OpenSourceEBike/ebike_wireless_remote/README.md

# DEPRECATED.
Use this one instead: https://github.com/OpenSourceEBike/TSDZ2_wireless
