OpenSourceEBike/ebike_wireless_remote/documentation/ant_lev+bluetooth_connected.png

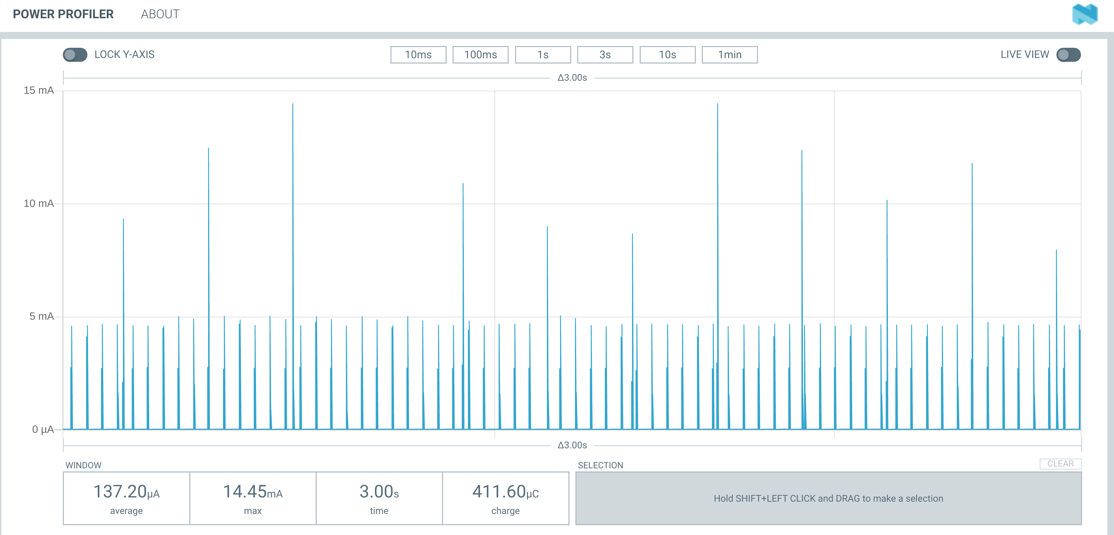
documentation/ant_lev+bluetooth_connected.png
