OpenSourceEBike/ebike_wireless_remote/documentation/ant_lev+bluetooth_idle.png

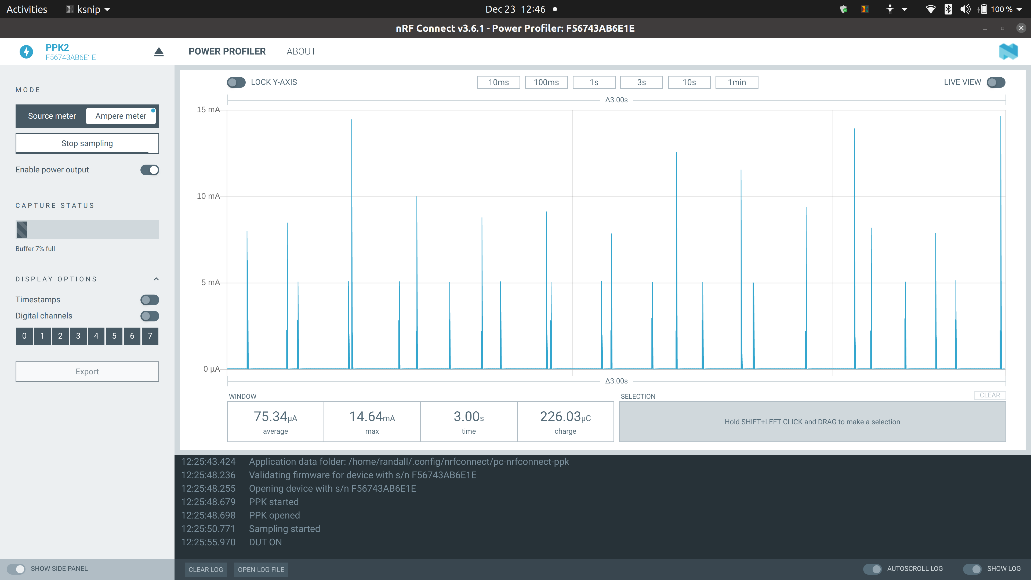
documentation/ant_lev+bluetooth_idle.png
