OpenSourceEBike/ebike_wireless_remote/documentation/ant_lev+bluetooth_pairing.png

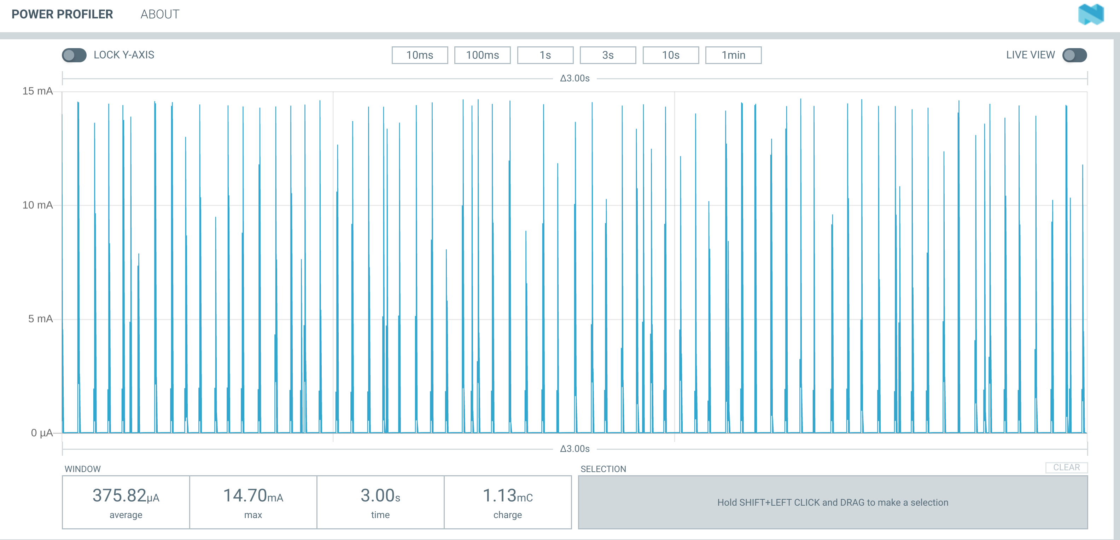
documentation/ant_lev+bluetooth_pairing.png
