OpenSourceEBike/ebike_wireless_remote/documentation/ant_lev+ctrl_2_sec_press.png

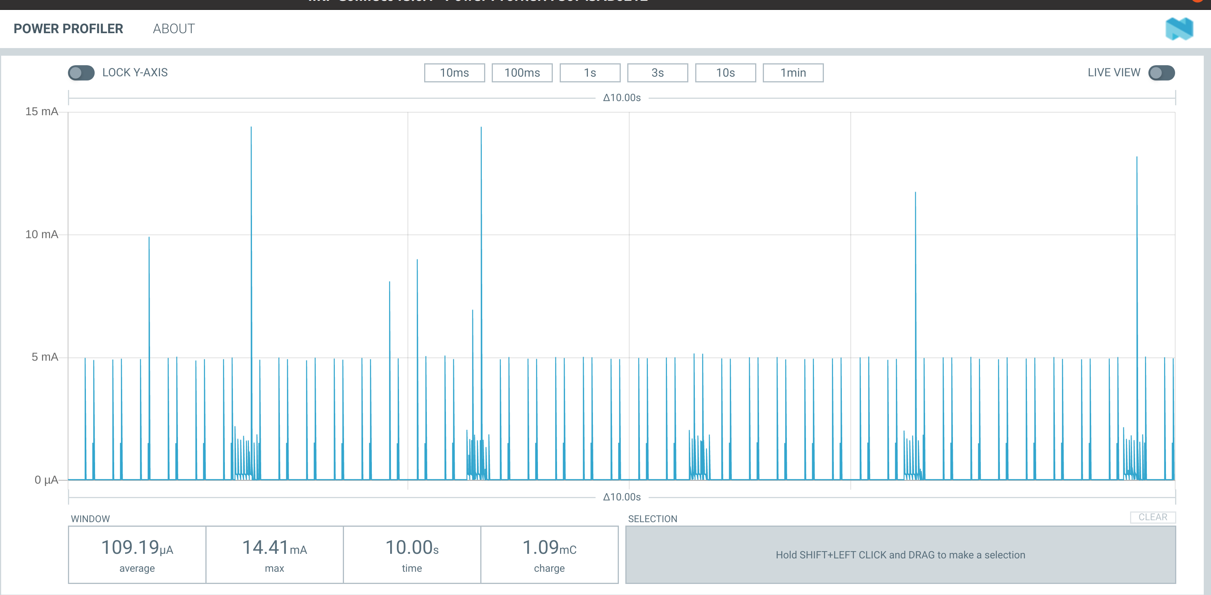
documentation/ant_lev+ctrl_2_sec_press.png
