OpenSourceEBike/ebike_wireless_remote/documentation/ant_lev+ctrl_idle.png

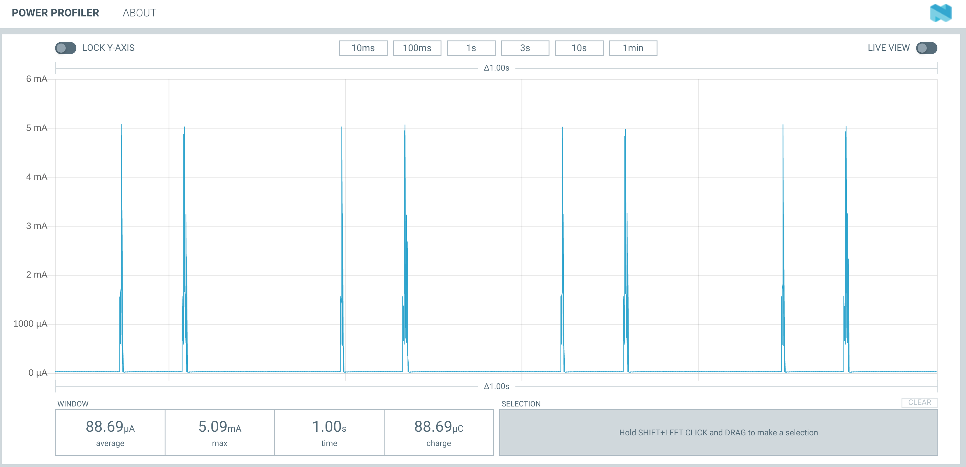
documentation/ant_lev+ctrl_idle.png
