OpenSourceEBike/ebike_wireless_remote/documentation/ant_lev_1_sec_press.png

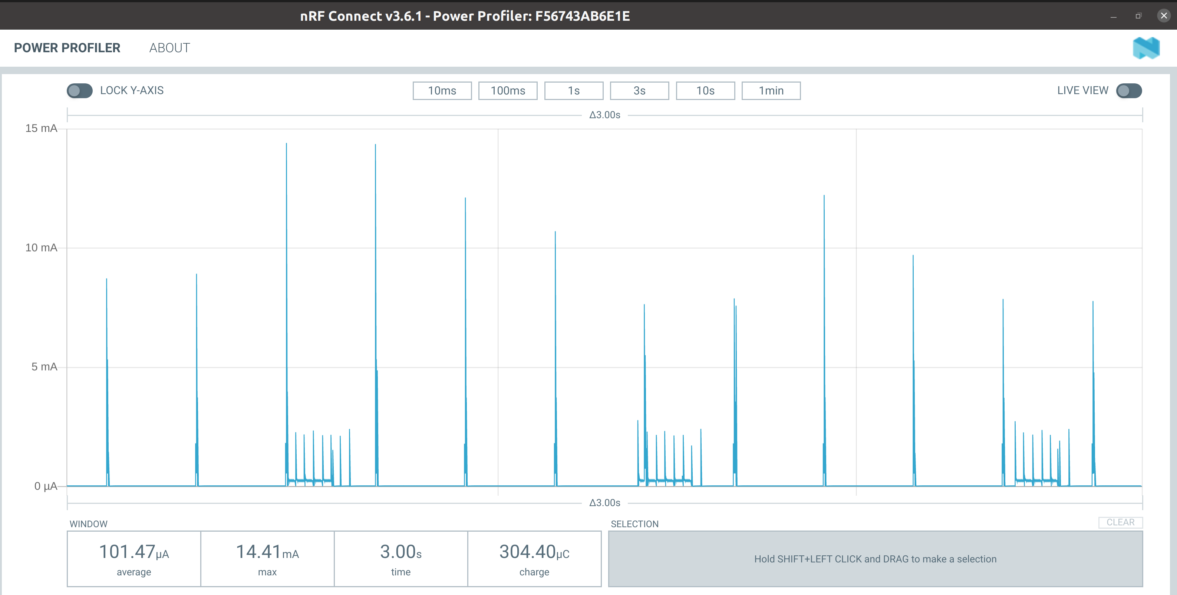
documentation/ant_lev_1_sec_press.png
