OpenSourceEBike/ebike_wireless_remote/documentation/ant_lev_2_sec_press.png

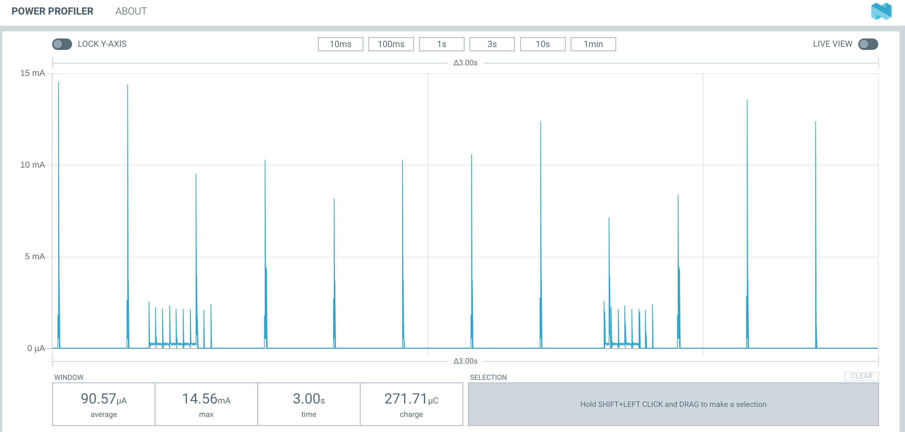
documentation/ant_lev_2_sec_press.png
