OpenSourceEBike/ebike_wireless_remote/documentation/ant_lev_idle.png

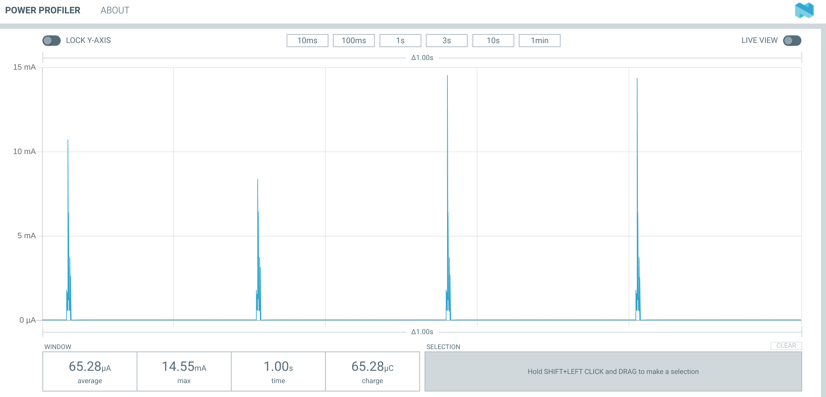
documentation/ant_lev_idle.png
