OpenSourceEBike/ebike_wireless_remote/documentation/ant_pairing.png

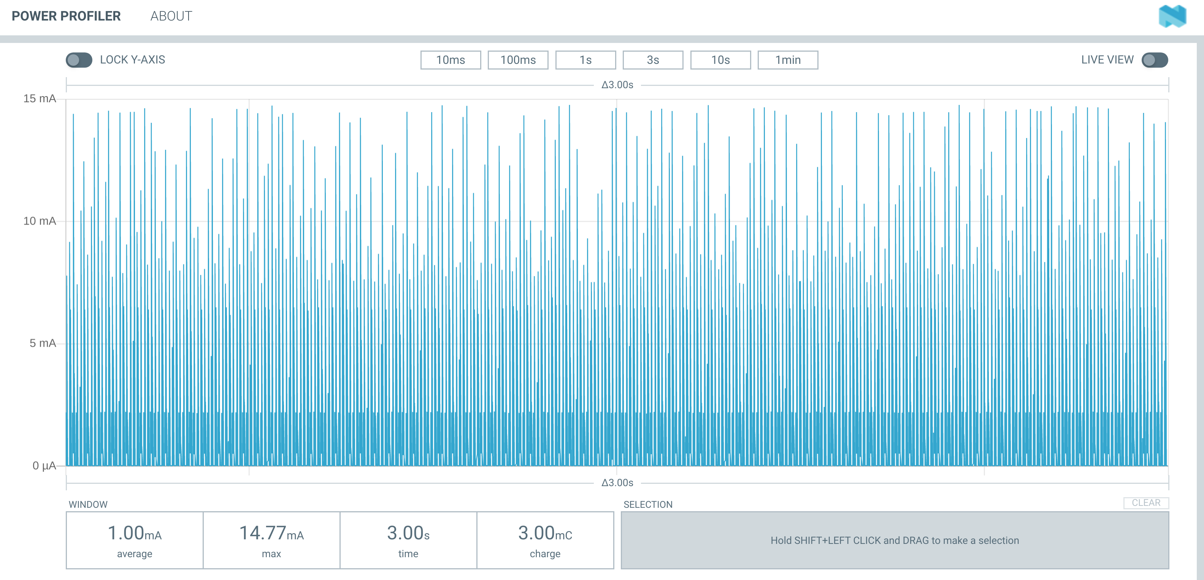
documentation/ant_pairing.png
