OpenSourceEBike/ebike_wireless_remote/documentation/battery_life.png

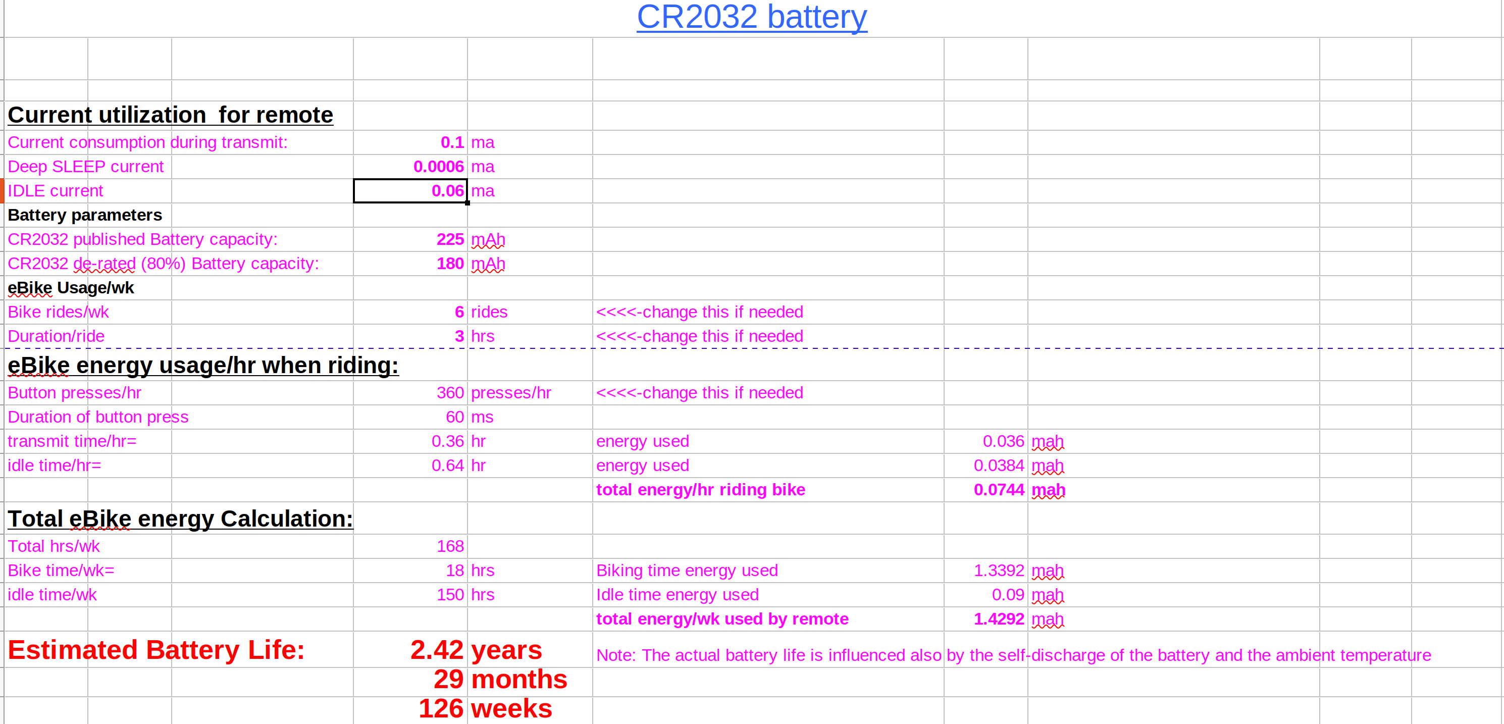
documentation/battery_life.png
