OpenSourceEBike/ebike_wireless_remote/documentation/capacity_vs_pulse_amplitude.png

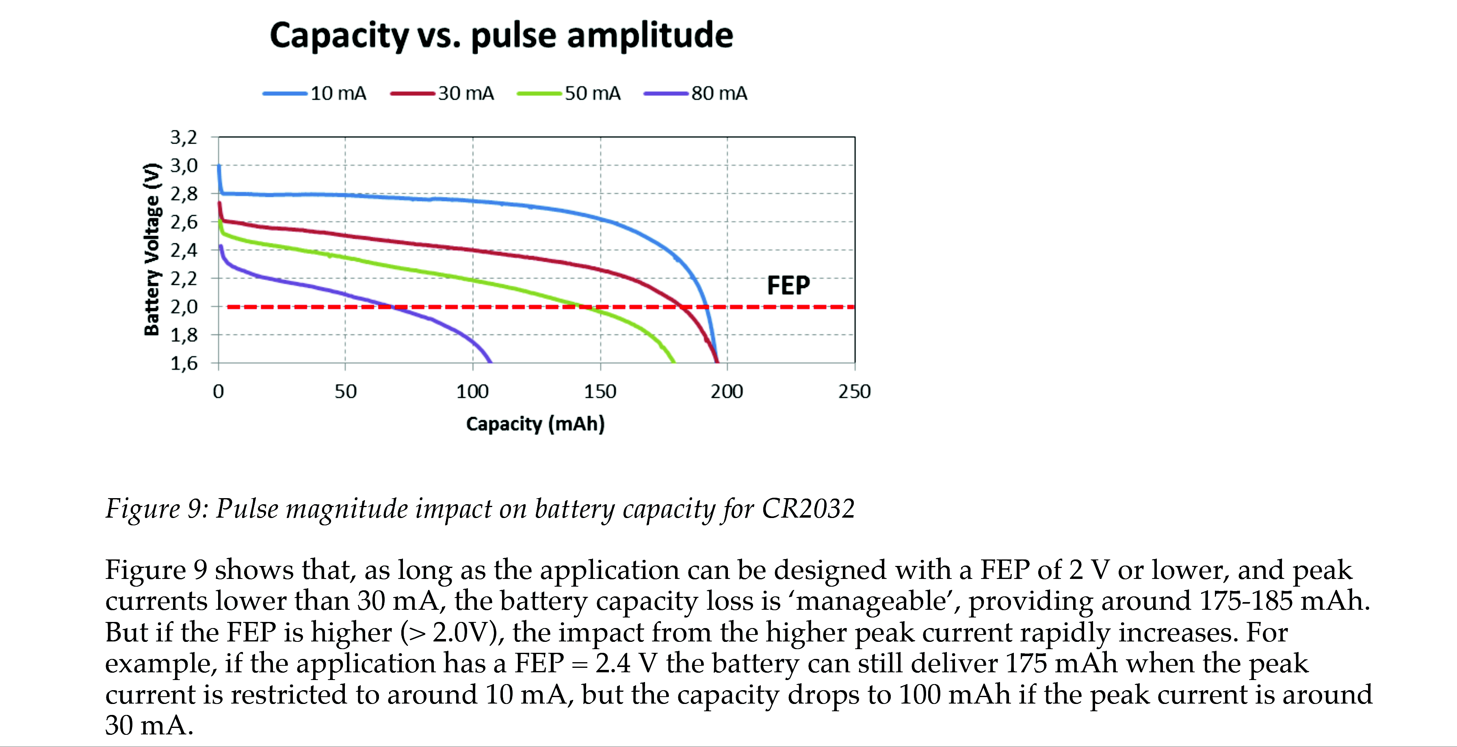
documentation/capacity_vs_pulse_amplitude.png
