OpenSourceEBike/ebike_wireless_remote/documentation/deep_sleep.png

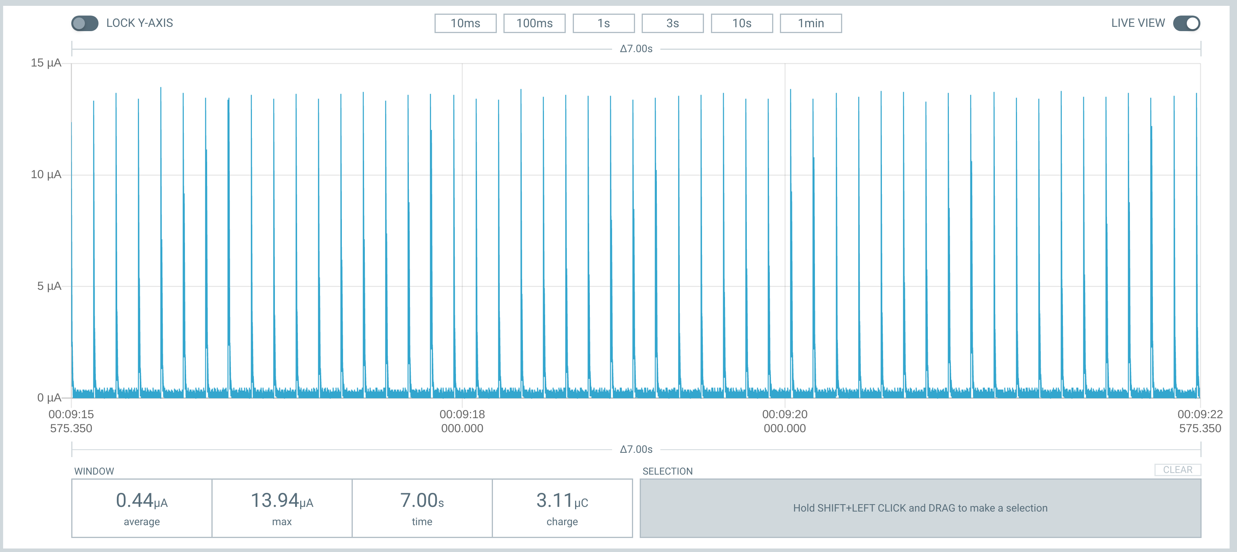
documentation/deep_sleep.png
