OpenSourceEBike/ebike_wireless_remote/documentation/duration_of_button_click.png

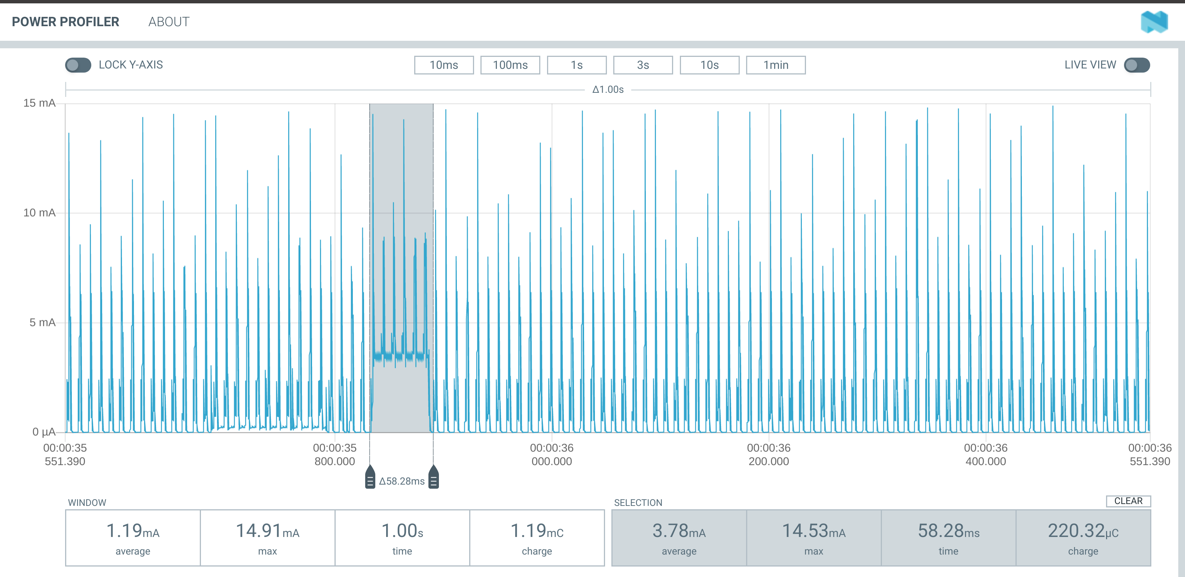
documentation/duration_of_button_click.png
