OpenSourceEBike/ebike_wireless_remote/documentation/external_power.png

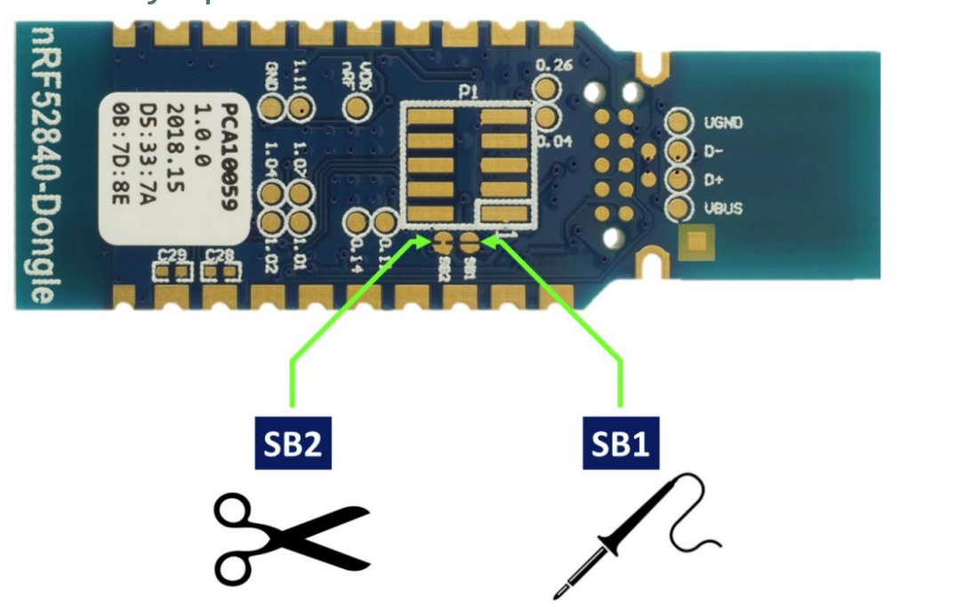
documentation/external_power.png
