OpenSourceEBike/ebike_wireless_remote/documentation/external_source.png

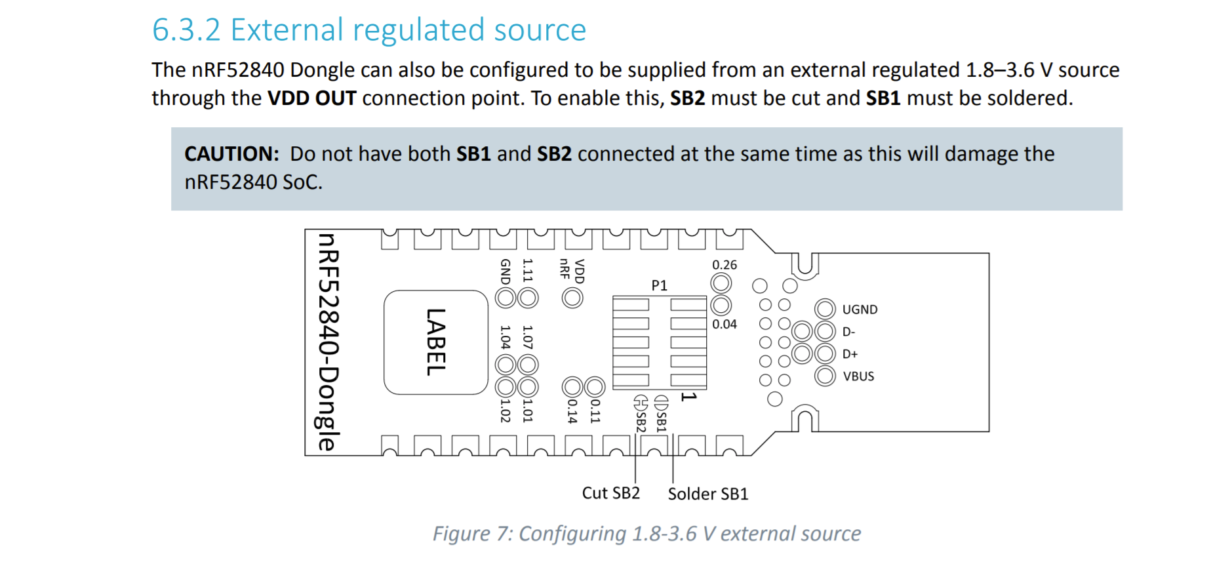
documentation/external_source.png
