OpenSourceEBike/ebike_wireless_remote/documentation/led_current.png

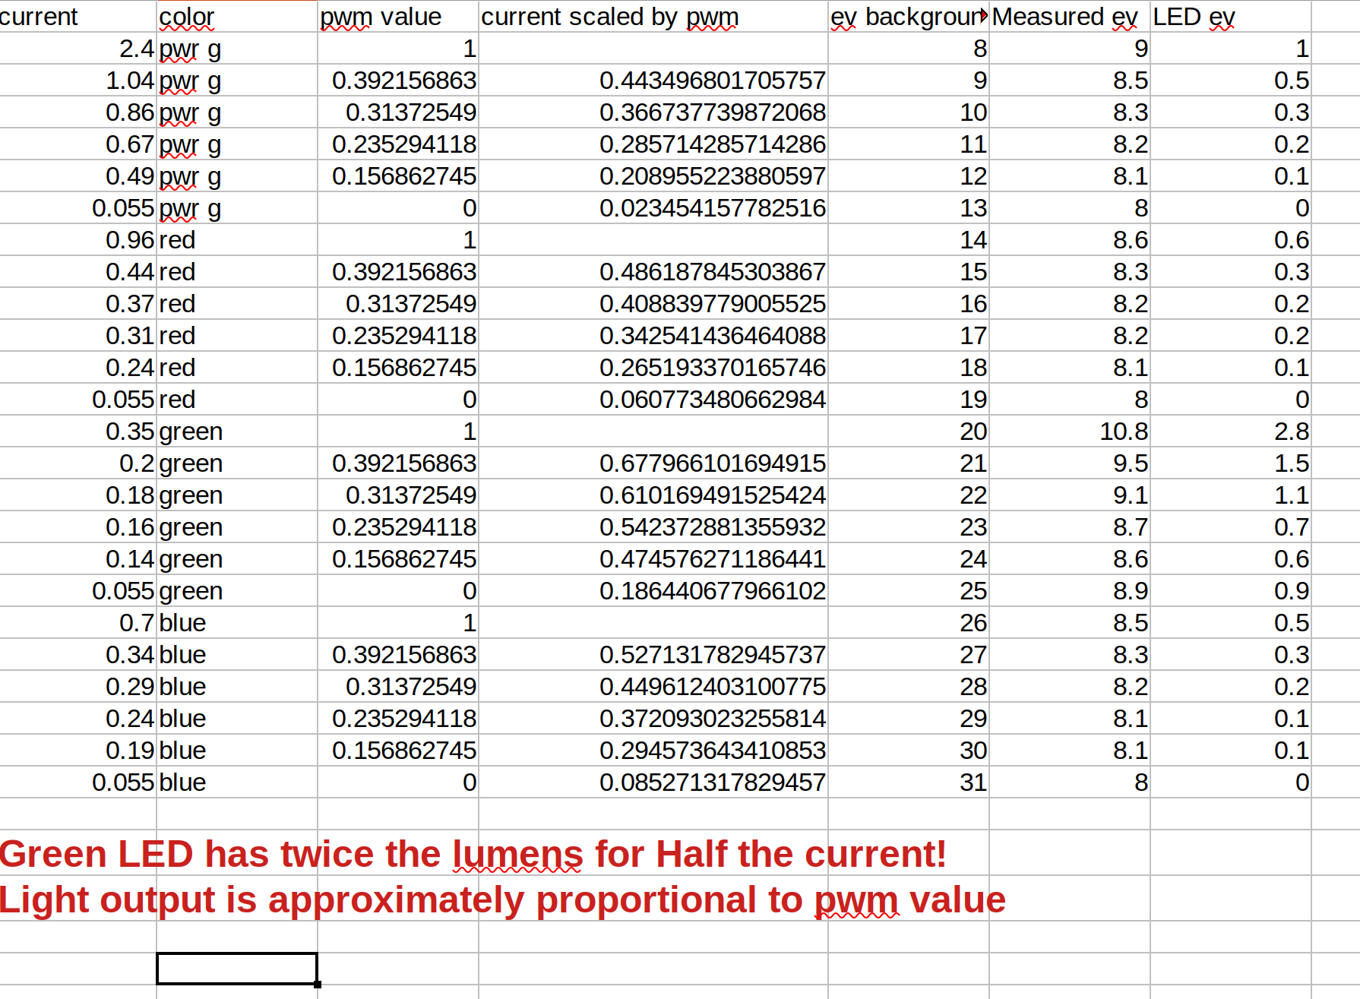
documentation/led_current.png
