OpenSourceEBike/ebike_wireless_remote/documentation/leds_active.png

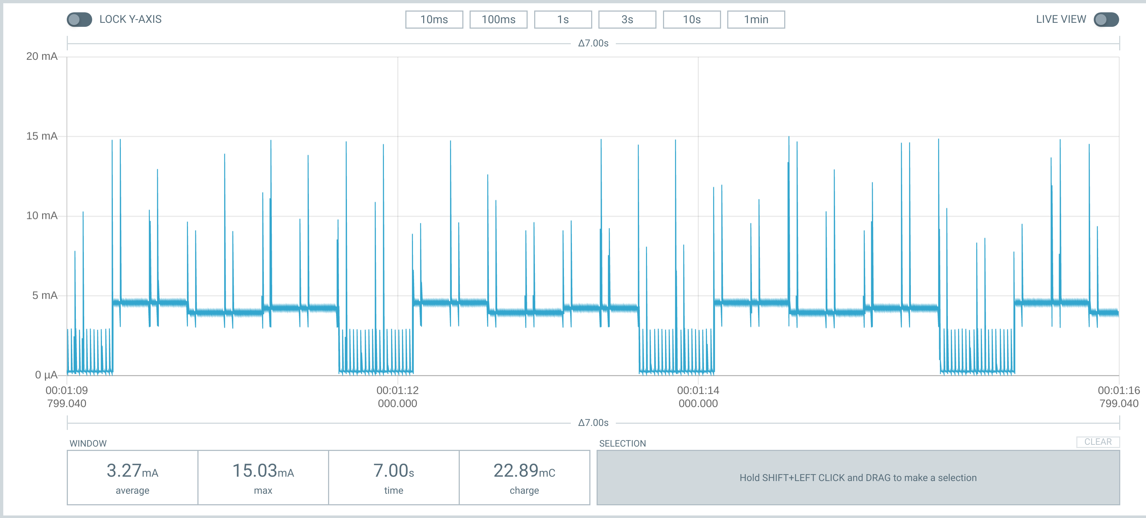
documentation/leds_active.png
