OpenSourceEBike/ebike_wireless_remote/documentation/no ant device found.png

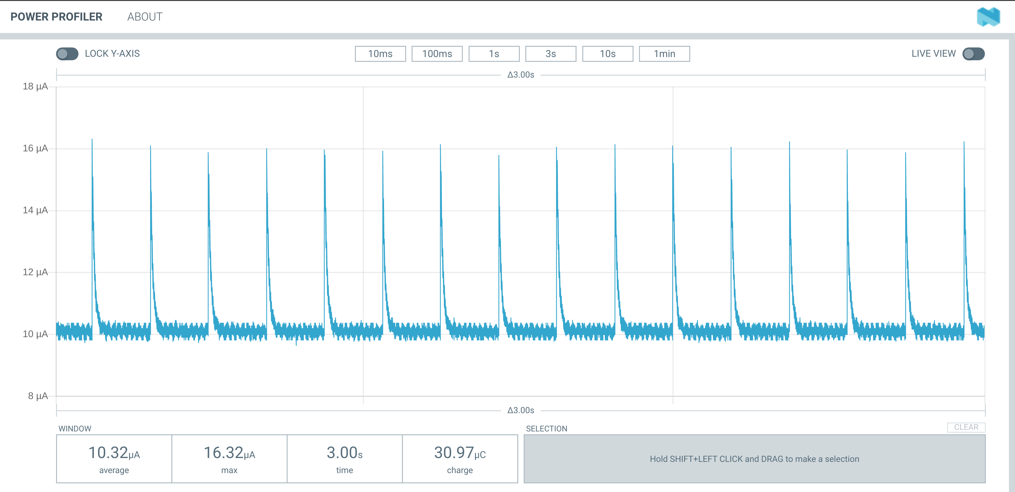
documentation/no ant device found.png
