OpenSourceEBike/ebike_wireless_remote/documentation/nRF52840 Dongle Pinout.png

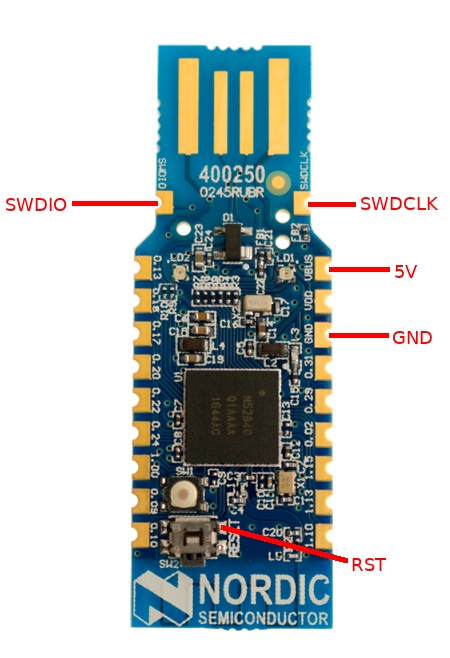
documentation/nRF52840 Dongle Pinout.png
