OpenSourceEBike/ebike_wireless_remote/documentation/openocd1.png

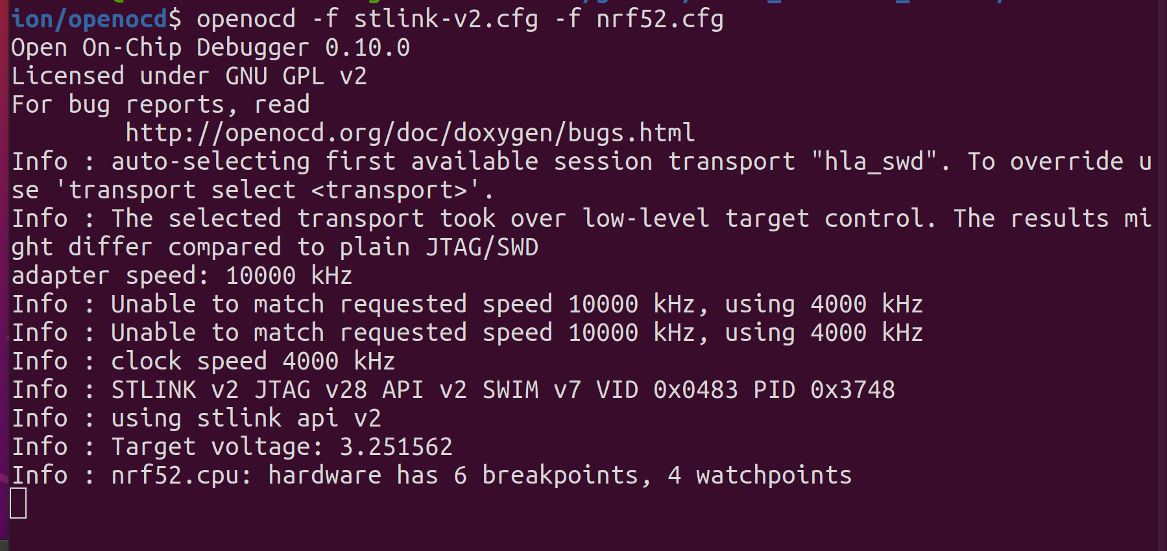
documentation/openocd1.png
