OpenSourceEBike/ebike_wireless_remote/documentation/openocd2.png

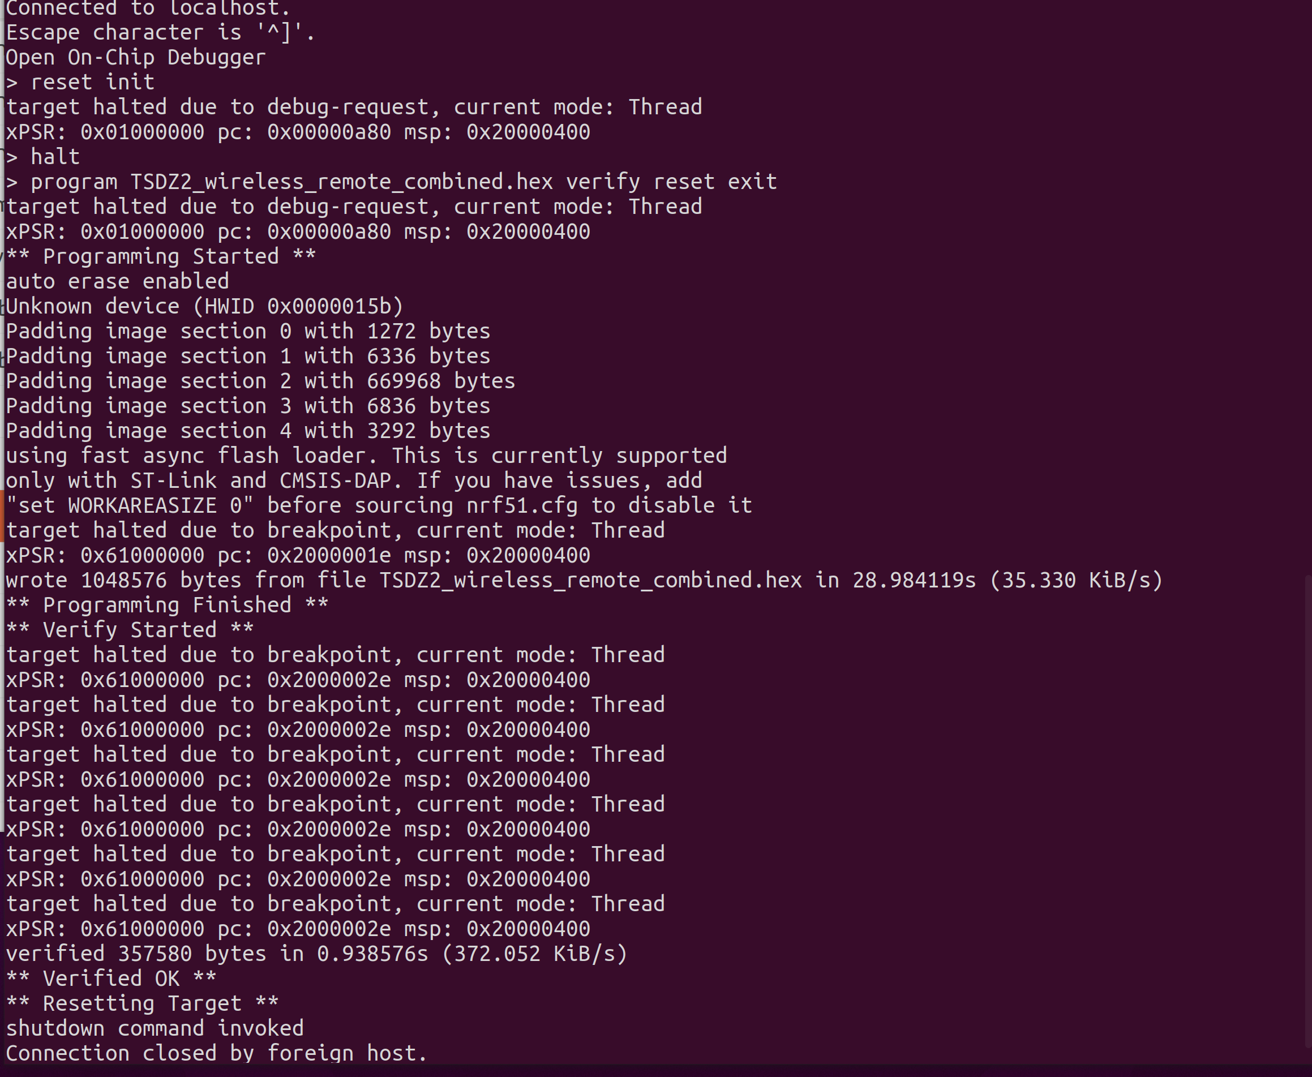
documentation/openocd2.png
