OpenSourceEBike/ebike_wireless_remote/documentation/openocd.png

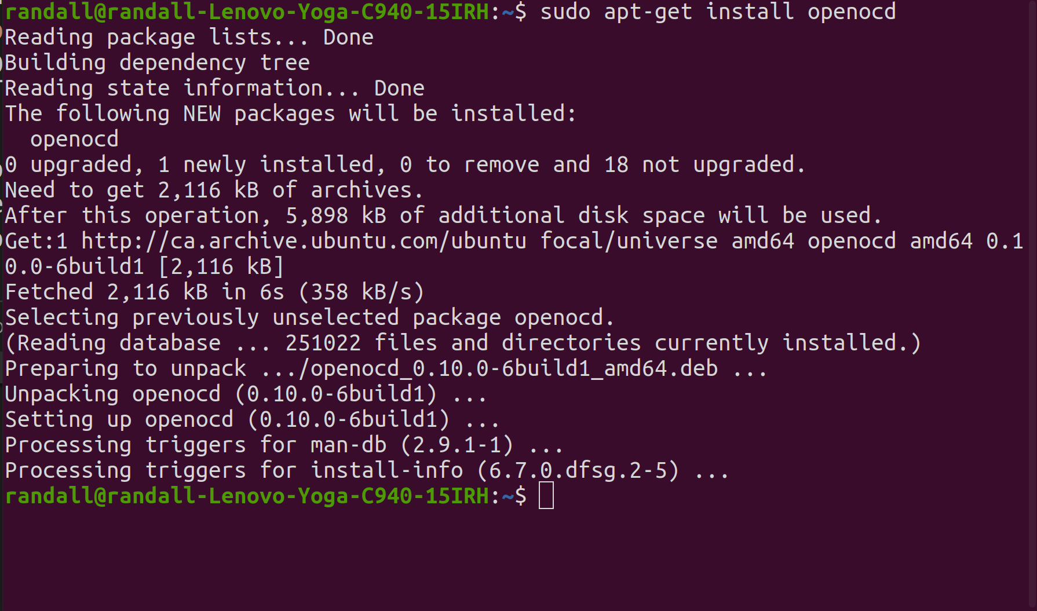
documentation/openocd.png
