OpenSourceEBike/ebike_wireless_remote/hardware/ebike_remote_wireless-picture-v1.png

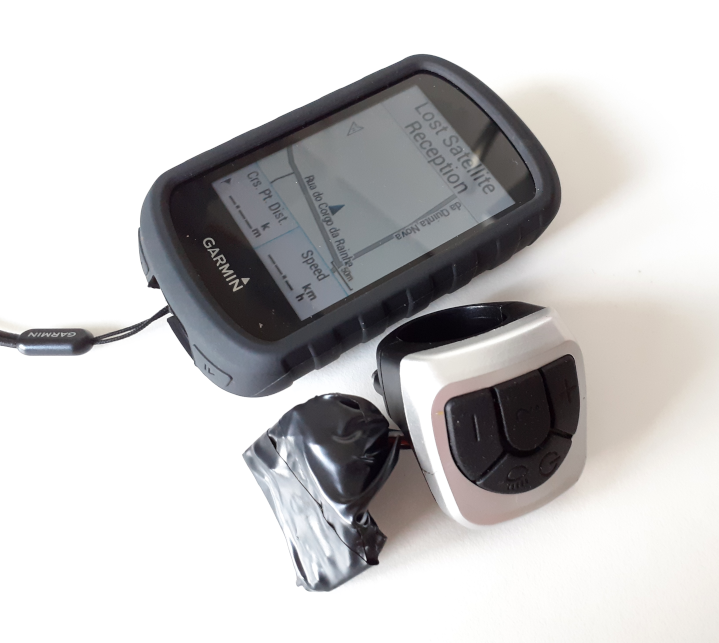
hardware/ebike_remote_wireless-picture-v1.png
