OpenSourceEBike/ebike_wireless_remote/3d_design/VLCD5_2.FCStd

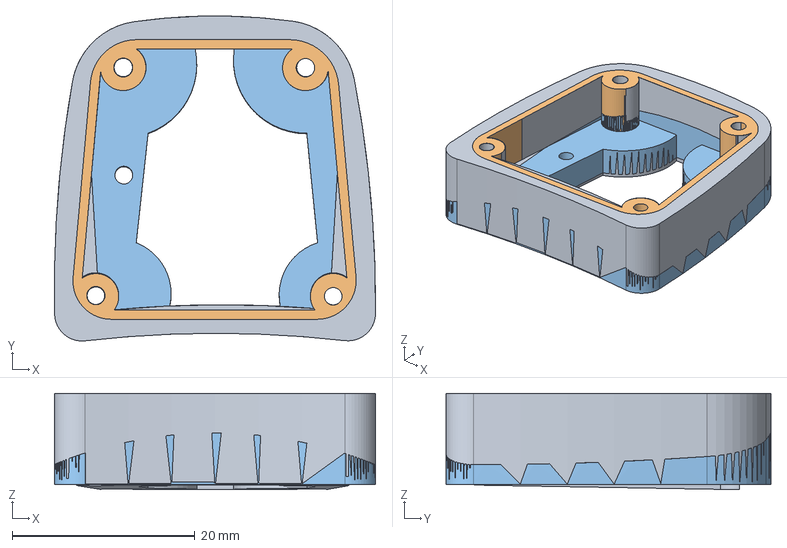
[picture p26: CAD file, 2020-10-02]
3d_design/VLCD5_2.FCStd
35.2 x 35.6 x 10.6 mm
