OpenSourceEBike/ebike_wireless_remote/3d_design/VLCD5_Spacer_Handle_Bar.FCStd

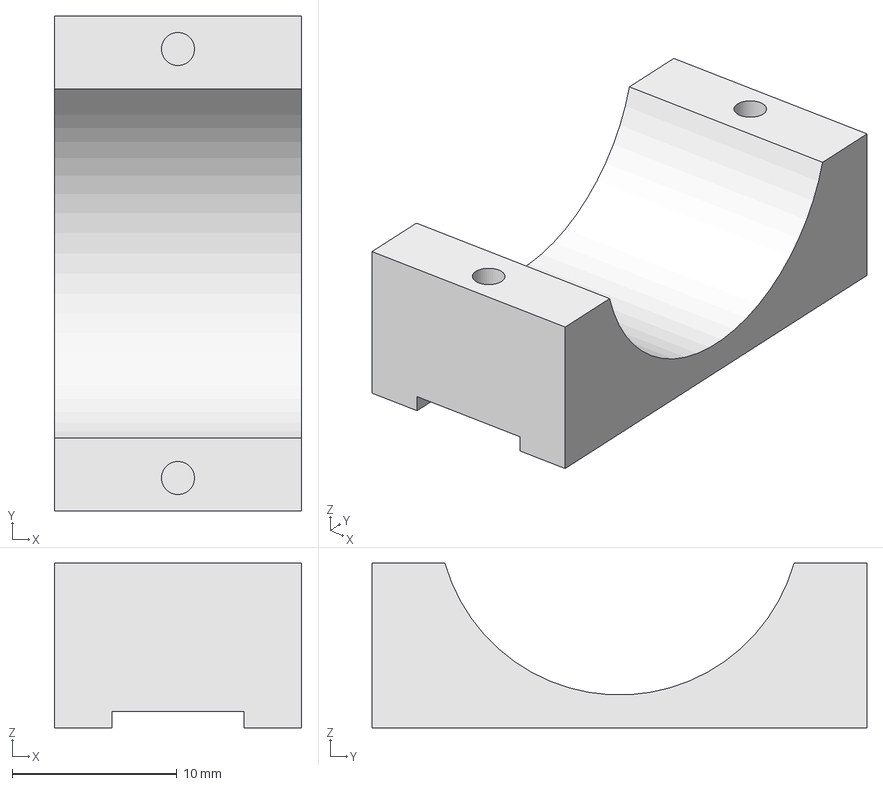
[picture p27: CAD file, 2020-10-02]
3d_design/VLCD5_Spacer_Handle_Bar.FCStd
15.0 x 30.0 x 10.0 mm
