OpenSourceEBike/ebike_wireless_remote/3d_design/VLCD5.stl

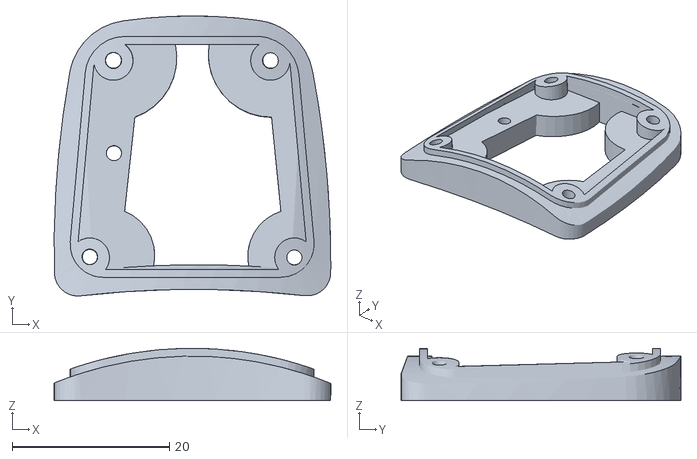
[picture p28: CAD file, 2020-10-02]
3d_design/VLCD5.stl
35.2 x 35.6 x 6.67
