OpenSourceEBike/ebike_wireless_remote/3d_design/VLCD5_LowerPart.FCStd

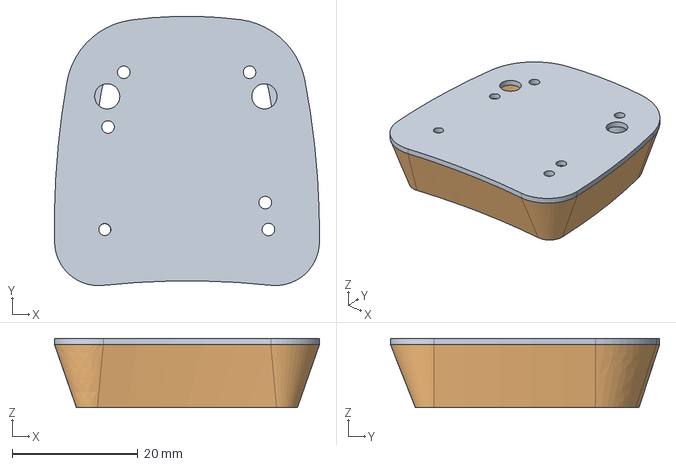
[picture p29: CAD file, 2020-10-02]
3d_design/VLCD5_LowerPart.FCStd
42.1 x 42.8 x 11.0 mm
