OpenSourceEBike/ebike_wireless_remote/3d_design/remote_base.FCStd

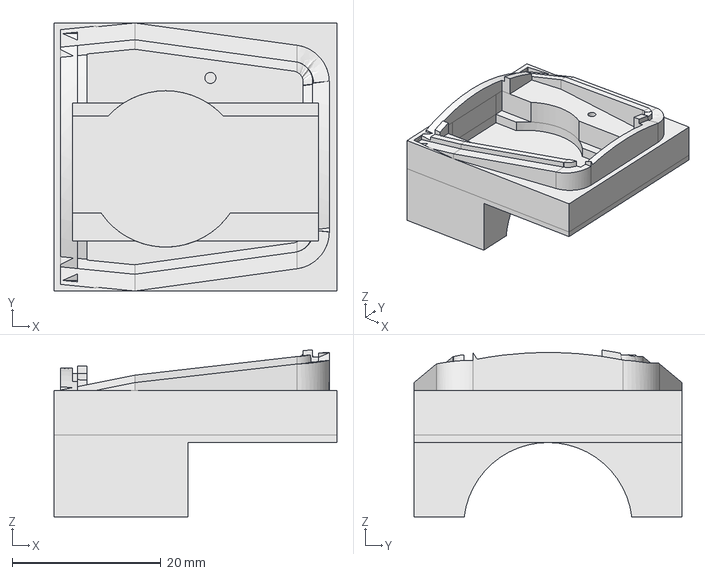
[picture p30: CAD file, 2020-09-10]
3d_design/remote_base.FCStd
38.0 x 36.0 x 22.4 mm
