OpenSourceEBike/ebike_wireless_remote/(list of files, cad)

Other CAD files:
3d_design/VLCD5_Lower_Part.stl
3d_design/VLCD5_Spacer_Handlebar.stl
