OpenSourceEBike/ebike_wireless_remote/(threads)

Thread 9 (2020-11-05):

Makefile:291: Cannot find include folder: ./nRF5_SDK_16.0.0/components/ant/ant_key_manager/config

stsdc, 2020-11-05:
Did I miss something when was making CI? Or is it just current state?

casainho, 2020-11-06:
Let´s see if @rananna can see this issue.

stsdc, 2020-11-06:
Looks like You approved code too early? 😅️

rananna, 2020-11-07:
this file is intentionally left out of the build as we are not allowed to distribute the Garmin provided ANT+ network keys to developers that have not registered on their website.
If you want to compile the code you need to register.
Situation described here:
https://www.thisisant.com/developer/resources/tech-bulletin/network-keys-and-the-ant-managed-network
since we are non commetcial we should be ok to use the key, but we still cannot distribute freely on github.

rananna, 2020-11-07:
@casainho, the compile problem because of the missing ANT+ network  keys needs to be fixed.
I propose to add an explanation to developers in the Readme that they need to get the key from Garmin. I will add a dummy key file to the firmware to eliminate the compile problem along with an explanation  to add the Garmin keys to this file so that Ant works.
Does this sound good to you?

casainho, 2020-11-07:
@rananna yes, please do that!!

Maybe you can also add warnings so the developers will see them while building the firmware, like:

#warning DUMMY ANT NETWORK KEY USED!! YOU NEED TO REGISTER, etc, etc
#warning https://www.thisisant.com/developer/resources/tech-bulletin/network-keys-and-the-ant-managed-network

rananna, 2020-11-07:
Good idea I will do that

casainho, 2020-11-07:
Maybe you do not need to add explanation on the readme but add short explanation on that warnings, a developers should understand a short explanation. Better to avoid duplication of information.

rananna, 2020-11-07:
Yes, I will add ro only the code . Better idea than readme mod.

rananna, 2020-11-07:
Do you know if you can force GCC to throw a user defined warning when compiling ?

casainho, 2020-11-07:
Yes, it is:

#warning text

#error text

error should stop the compilation which is not what we want because we want the build tests to pass.

rananna, 2020-11-07:
Perfect! Just what I need. Thanks!

stsdc, 2020-11-07:
This might be useful: [Encrypted secrets](https://docs.github.com/en/free-pro-team@latest/actions/reference/encrypted-secrets).  It is better not to store any secret keys in the repo.
Also I have a questions. Please correct me if I'm wrong.
1. The only purpose of ANT+ is to connect this remote with *TSDZ Wireless* (and other devices that support this protocol)?
2. So every person that wants to use this firmware-hardware stack should acquire a key?
3. But is it possible to use *TSDZ Wireless* without remote? Only a mobile app?

rananna, 2020-11-07:
ANT+ is needed by the remote to communicate with the TSDZ2 (and any other ebike supporting ANT+ LEV) as well as the Garmin edge bike computers.
Every developer that wants to link this ANT + stack will need to acquire the developer key from Garmin.
I will let @casainho answer the question on the use of the wireless controller  without the remote.

stsdc, 2020-11-07:
What I'm thinking is that we might still distribute the binaries, just without ANT+ support. So only an app will be working.

Also, I don't know how it is working right now, but would be cool to just paste the developer key into an app. And the app will send it to *remote* and *TSDZ wireless*. So there will be no need to hardcode the key.

casainho, 2020-11-07:
If we want to buy the licenses then we would need to do it both for ANT and Bluetooth. As this is not a commercial project, I think there is not issue with that. I think the shops that are now selling TSDZ2 with our firmware installed, will need to pay the licenses before selling the product.

We will need to put this information clear on the project page.

stsdc, 2020-11-07:
OK. So, if You will build binary with Your key, is it OK to make this binary publicly available?

casainho, 2020-11-07:
Yes. The ANT key is the same for everyone, I already found it on a github of some project.

stsdc, 2020-11-07:
OK. So, are we going to put just in the repo, or in [encrypted secrets](https://docs.github.com/en/free-pro-team@latest/actions/reference/encrypted-secrets)?

casainho, 2020-11-07:
I don´t know. I am busy developing the firmware connection to / and Android app. That encrypted secrets is new to me, it is not my priority right now.

Maybe you can help with it?

stsdc, 2020-11-07:
It requires collaborators/admin access to repository. I don't know if You want to give it to a random person 😅️

I'm just concerned about the distribution of binaries by CI, but if firmware<->Android app will work without the key it is not urgent.

casainho, 2020-11-07:
OK, I see. If the releases are manual, then I will build with the key when making the release HEX files.

If the secrets required admin to repository, if you write some sequence list of steps, I can do it.

stsdc, 2020-11-07:
The point is to make releases automatic. I may try write a script that will inject a secret into a code.

stsdc, 2020-11-29:
We have this error again.

rananna, 2020-11-29:
I think this happens when @Casainho does a PR merge.
I have the file in .gitignore on my computer, so it is not uploaded to github in my repository.
Not enough of a GitHub expert to know how to fix this so it doesn't delete the demo file in the main repo.

stsdc, 2020-11-29:
To build on CI we should use secrets. We should prepare simple txt file with this key. In `Makefile` we should check if this file is not empty and inject the key into the code. If key file is empty, it means we are running `make` in CI, so key will be taken from env variable.

Closed 2020-12-03.

Thread 48 (2021-01-19):

Merge firmware repositories, use Docker image for build?

charliebruce, 2021-01-19:
It's come up a few times in discussion, most recently in #47 - at the moment the project seems to be split across multiple repos, and each has a copy of the nRF5 SDK, possibly with some modifications applied. This structure ends up being a pain to work with - the repo is quite large as a result of the SDK, submodules aren't very user-friendly, and CI builds are fragile.

I've had good success on multiple projects using Nordic chips, by setting up as follows:

* App, bootloader and manufacturing test app all exist in a single repo.
* Each of the above sub-projects is built by a main Makefile. The main Makefile then generates the DFU package and merged hex file.
* Building takes place within a [Docker environment](https://github.com/charliebruce/nrf5-docker-build), containing the nRF5 SDK, GCC toolchain and a few helpers (eg `srec_cat`). I've built one of these images for each revision of the nRF5 SDK.
* The root Makefile overrides the relevant environment variables, so you should be able to use the stock Nordic Makefiles for each sub-project. The only thing I think you need to add is to override the default hardware version ID in the Bootloader (defaults to `52` for all products otherwise)
* Github Actions builds each commit for each hardware revision which exists. Each hardware revision runs in a separate job, and uploads the artefacts.
* When building locally, each hardware revision is built into a different build directory, avoiding the need for a clean rebuild when changing pinout for example. You'd run `make PCBVER=2` to change PCB/wiring version, which would automatically build into a new build directory. This should make it easier in future if custom PCBs are being made / there end up being different hardware or schematics in use.

I've released an example project [here](https://github.com/charliebruce/nrf5-example-project) which demonstrates all this functionality. It should pretty much be possible to drop the app into a new directory called `app`, bootloader into one called `boot`, set up the correct SDK version in `products.mk`, and call `make` in the root directory.

One possible sticking point - at one point Docker required Windows Pro for good performance, and Docker's generally a bit heavy. Might discourage some contributions from people with lower-end machines. Not sure if this is still an issue.

I don't have the time or a full understanding of how the team likes to work, so I didn't want to jump in and majorly restructure these repos and possibly break people's existing flows, but I would be happy to do so if everyone's happy with this (may take a little while to get around to this). Alternatively, happy to give any help/advice/review if someone else wants to take this on instead.

Would welcome any thoughts/discussion on this!

casainho, 2021-01-20:
I appreciate the help.

The main reason to make this new change was because of the need to reuse some code between all projects. Right now I do not feel the need to anything more, so, why take more time learning new tools instead of developing the project?

I develop on a small 9 inches, low power, laptop GPD P2 MAX, so I want to avoid docker - I had some small experience professionally and I could understand it was very slow on this small and low power laptop, so I want to avoid use it.

Closed 2021-01-20.
