OpenSourceEBike/ebike_wireless_remote/documentation/nrf52840-mdk-usb-dongle-sch_v1_0.pdf

## Function Description

## Page

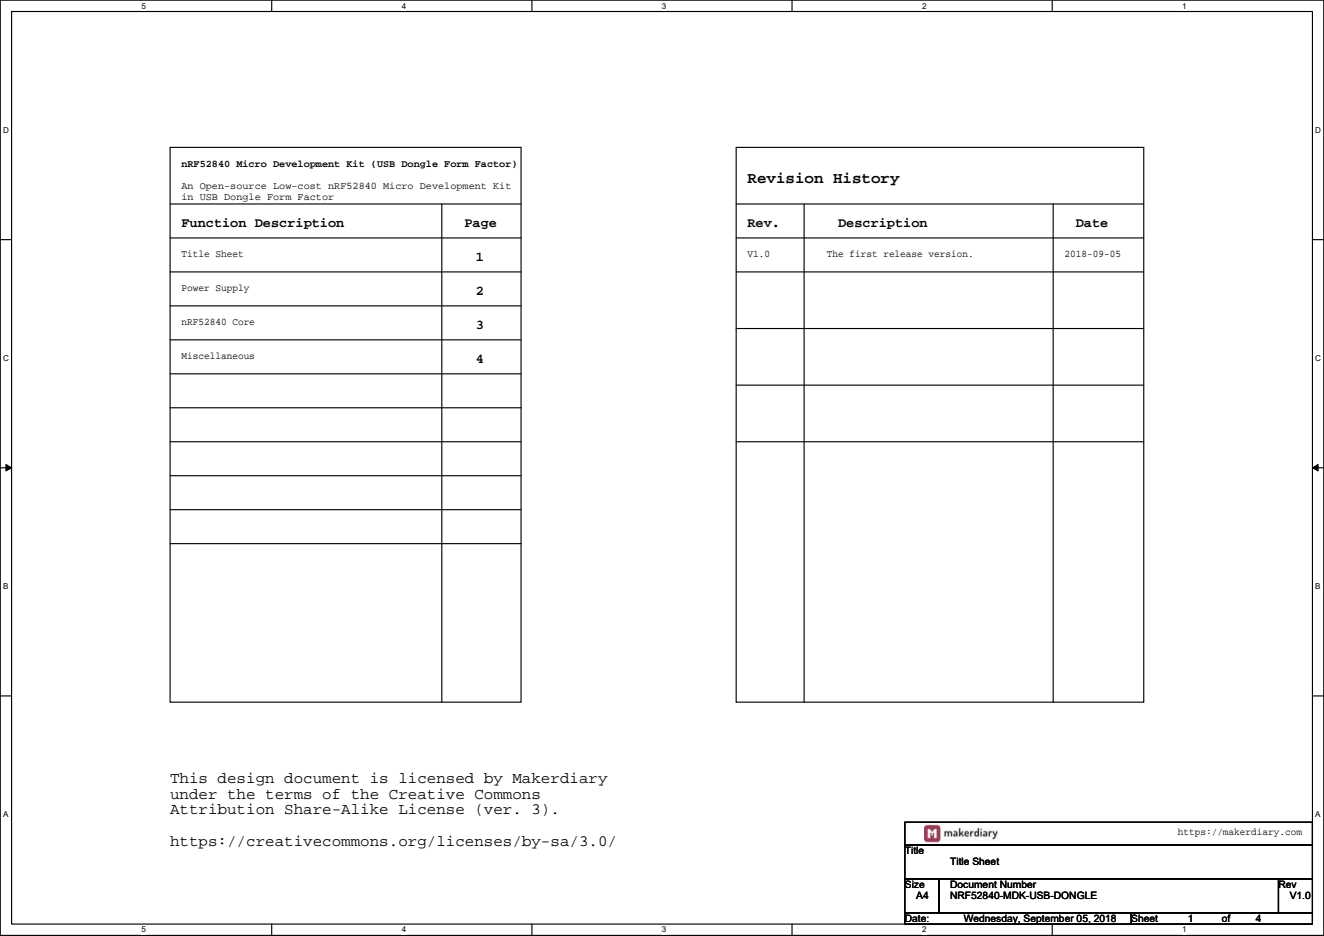
[picture p38: page 1]
Title Sheet; Revision History; Rev.; Description; Date; https://creativecommons.org/licenses/by-sa/3.0/; https://makerdiary.com Title; Title

nRF52840 Micro Development Kit (USB Dongle Form Factor)
An Open-source Low-cost nRF52840 Micro Development Kit
in USB Dongle Form Factor

The first release version.

Power Supply | 2

nRF52840 Core | 3

Miscellaneous | 4

This design document is licensed by Makerdiary
under the terms of the Creative Commons
Attribution Share-Alike License (ver. 3).

Size A4 | Document Number NRF52840-MDK-USB-DONGLE | Rev V1.0

Date: Wednesday, September 05, 2018 Wednesday, September 05, 2018 Wednesday, September 05, 2018 | Sheet 1 1 1 of 4 4 4

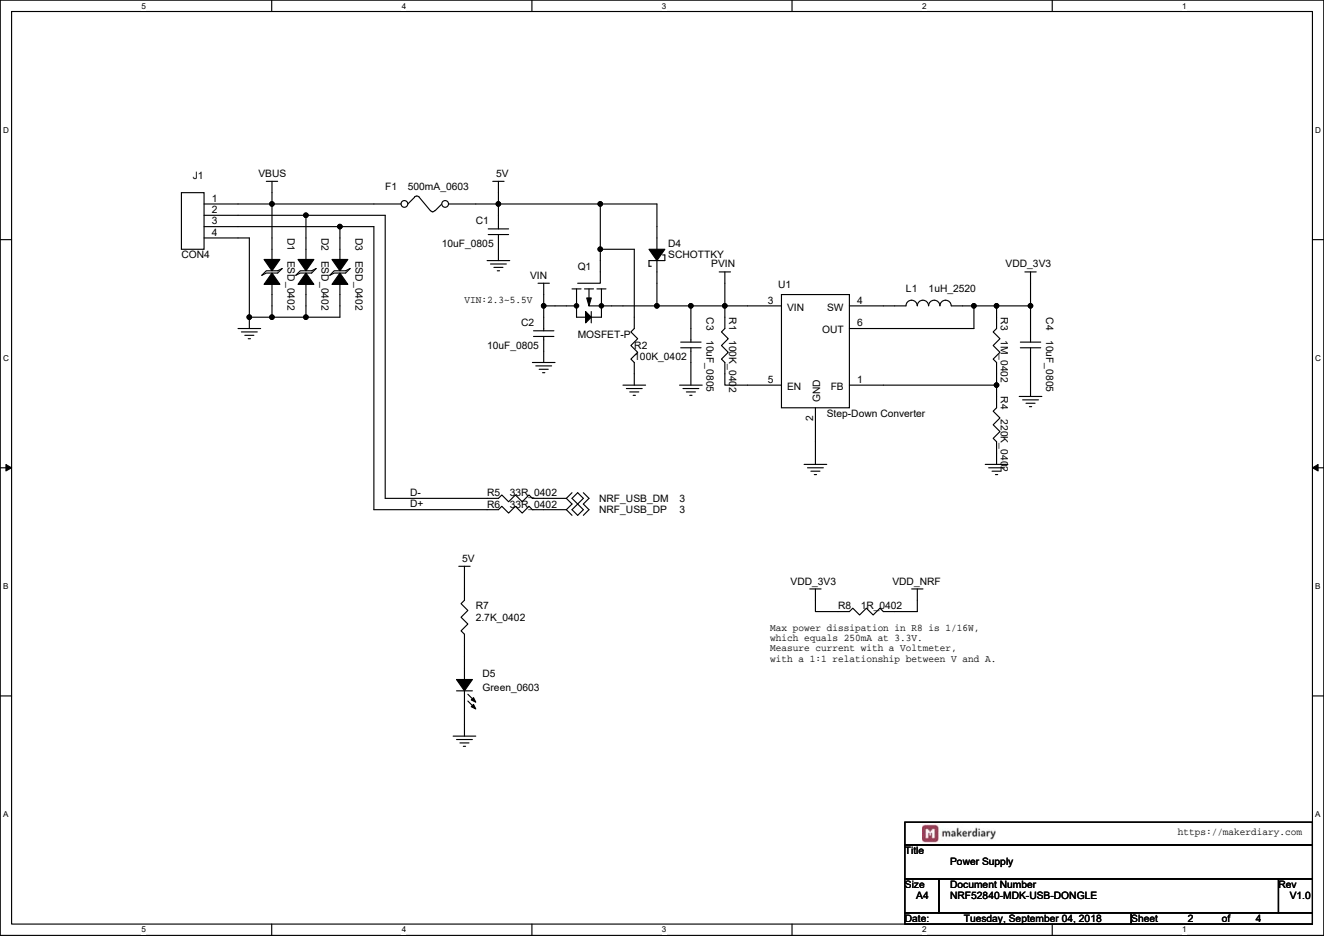
[picture p39: page 2]

Max power dissipation in R8 is 1/16W,
which equals 250mA at 3.3V.
Measure current with a Voltmeter,
with a 1:1 relationship between V and A.

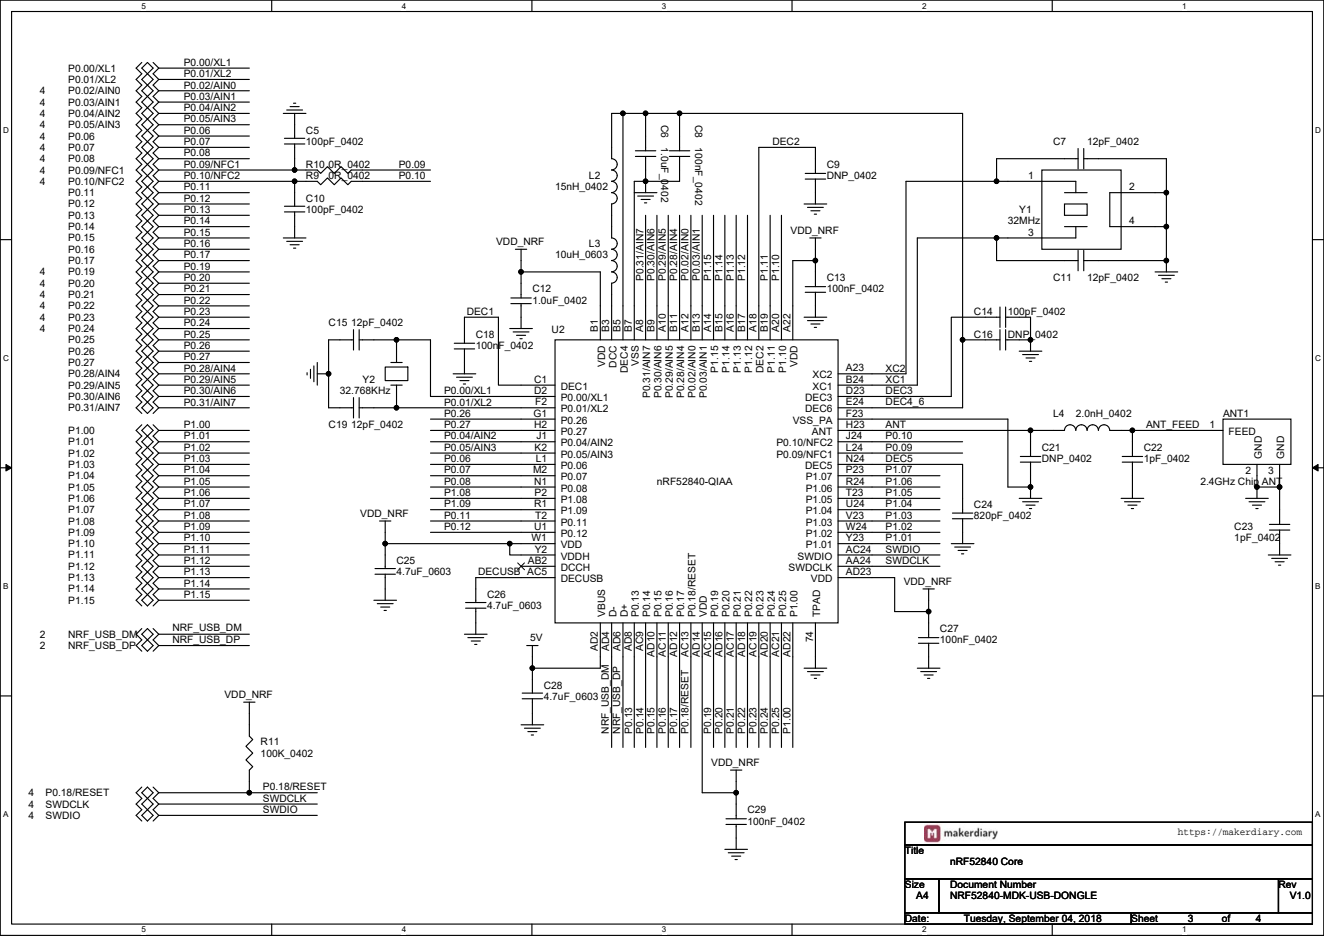
[picture p40: page 3]

VDD A22 P1.10 A20 P1.11 B19 DEC2 A18 P1.12 B17 P1.13 A16 P1.14 B15 P1.15 A14 P0.03/AIN1 B13 P0.02/AIN0 A12 P0.28/AIN4 B11 P0.29/AIN5 A10 P0.30/AIN6 B9 P0.31/AIN7 A8 VSS B7 DEC4 B5 DCC B3 VDD B1

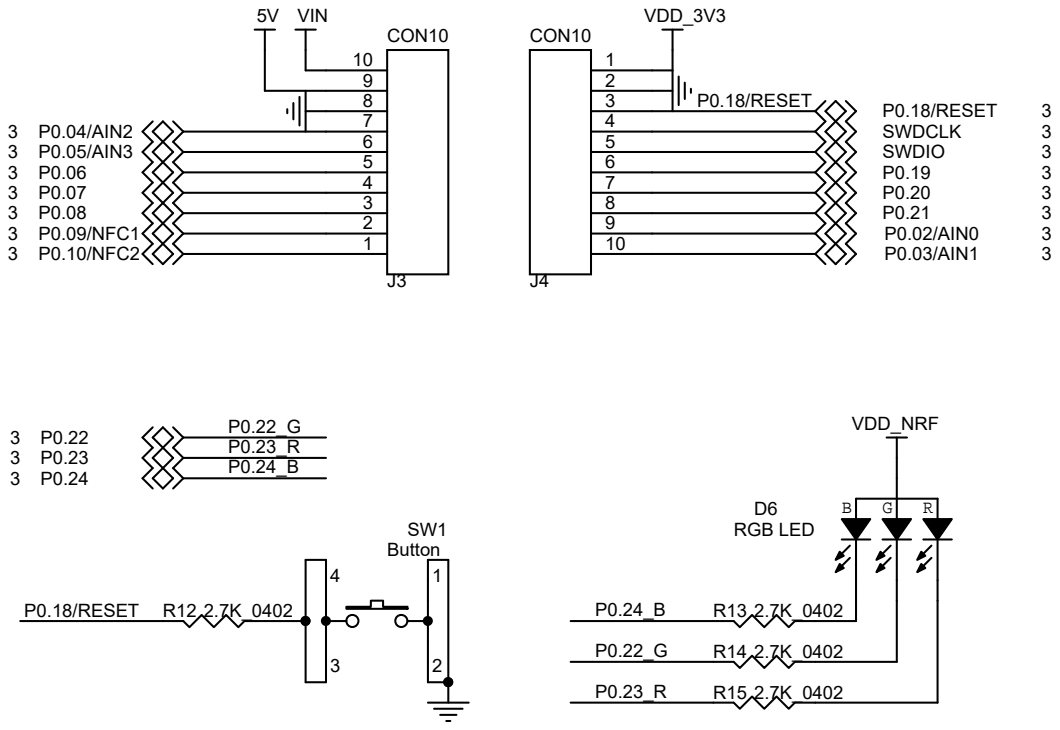
[picture p41: page 4]
