OpenSourceEBike/ebike_wireless_remote/hardware/ebike_remote_wireless.sch

## KiCad design hardware/ebike_remote_wireless.sch (2020-08-28)

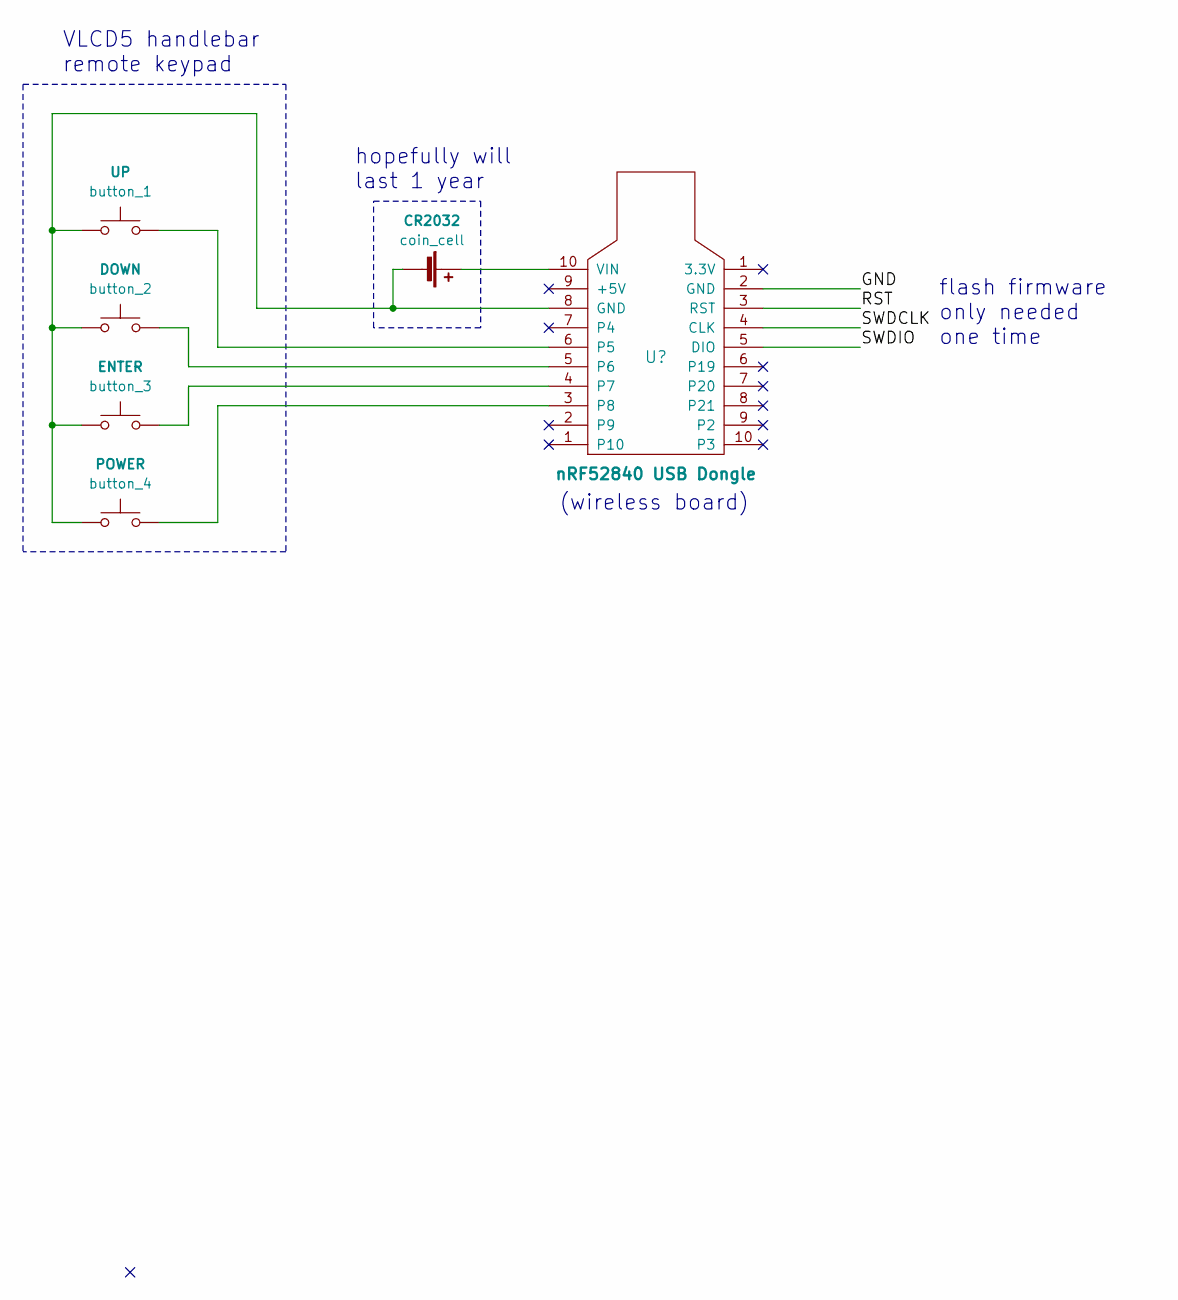
[picture p42: schematic ebike_remote_wireless.sch]

Parts:
button_1: UP
button_2: DOWN
button_3: ENTER
button_4: POWER
coin_cell: CR2032

Connections:
unnamed: button_1.1, button_2.1, button_3.1, button_4.1, coin_cell.2 (-)

Notes on the sheet:
(wireless board)
flash firmware only needed one time
hopefully will last 1 year
VLCD5 handlebar remote keypad
