OpenSourceEBike/ebike_wireless_remote/(commit log)

2020-08-13 Added firmware sources -- not finish
    [nrf52.cfg, stlink-v2.cfg]
2020-08-16 WIP: Edge 830 just reacts to first button press / first message sent but after blocks, no more reaction to buttons
2020-08-25 WIP: power managment works
2020-08-27 Works: low power and ultra low power work
2020-08-28 Added thee schematic
    [ebike_remote_wireless.sch]
2020-08-28 Added schematic for the wireless board and datasheet of CR2032 button cell
2020-09-10 Added experimental 3D design for the remote
    [remote_base.FCStd]
2020-11-05 added bluetooth and cleaned up (#8)
    * bluetooth ANT Device Nmber changing works
    * Blutooth implementation
2020-11-07 fixed commit issue because of ant keys (#13)
    * Create test.c
    * Add files via upload
    * Add files via upload
    * Delete README.md
    * change readme
    * readme
    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
2020-11-13 buttonless dfu working! (#14)
    * Squashed commit of the following:
    commit 51f5e49450110ad53955922cf3f1c3acfca075ce
    Author: rananna <rnorth@kitavar.com>
    Date: Thu Nov 12 17:35:10 2020 -0500
    wip
    commit e10998bec569e203dd5709e2a95b4c7a869f5b51
    Author: rananna <rnorth@kitavar.com>
    Date: Thu Nov 12 11:04:39 2020 -0500
    working!
    commit dc71bfe05c68a06bcb6fc2be25cc4db8140b5e26
    Author: rananna <rnorth@kitavar.com>
    Date: Wed Nov 11 21:00:10 2020 -0500
    wip
    commit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
2020-11-15 fixed launch.json (#15)
    commit 59367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
2020-11-25 removed the buttonless DFU code (#16)
    * remove buttonless code for dfu
    * remove buttonless code for dfu
2020-11-29 set up configuration flash flags for ANT LEV and ANT control (#24)
    * trying again
    * readme changes
    * Fix timeout problem with bluetooth
    * flash configuration changes
    * fix makefile so it can build
    [main.c, sdk_config.h]
2020-12-02 Config display option added, DFU entry made consistent, brake flag added (#25)
    * brake flag, config led display and DFU
    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
    [main.c]
2020-12-04 cleaning up in preparation for a release version coming soon (#29)
    * cleaned up code
    * cleaned up directory
    * new docs
    * fixed first level header issue
    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
    [VLCD5_LowerPart.FCStd, VLCD5_Lower_Part.stl]
2020-12-06 created docs for flashing with both ubuntu and windows (#30)
    * Created Docs for flashing in ubuntu and windows
    * getting started doc change
    * getting started mods
    * delete file
    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
    [nrf52.cfg, stlink-v2.cfg]
2020-12-07 Release v1.0.0 (#31)
    * Release v1.0.0
    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
2020-12-13 switch to the Nordic dongle (#32)
    * switch to the nordic dongle
    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
    [nrf52.cfg, stlink.cfg]
2020-12-14 added ENTER + STANDBY pin DFU mode to match the bootloader firrmware (#33)
    * added STANDBY + ENTER pin DFU mode for remote
    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
    [main.c]
2020-12-14 Flash red led briefly during long button press (#34)
    * flash red led for long press feedback
    * Merge branch 'master'
    * flash led on long press
    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
    [main.c]
2020-12-15 trying again with new docs (#36)
    * updated docs
    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
2020-12-16 turned off the pwr led (#37)
    * control pwr led
    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
    [main.c]
2020-12-18 merge from clean (#38)
    * Squashed commit of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
    [main.c, pins.h]
2020-12-25 Fixed pwr handling, added pwr analysis docs (#39)
    * control pwr l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
    [Battery_Life_Calculator.xls]
2020-12-26 fixed docs/understood ant timeout issue/led pwr analysis (#40)
    *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
    [main.c]
2020-12-31 LED PWM implemented, ANT LED search indication (#42)
    * control pw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
    [led_current.xlsx]
2021-01-01 ANT timeout /pwr improvements (#43)
    * Squash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
    [main.c, sdk_config.h]
2021-01-02 Disable ram retention (#44)
    * Squashed commi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
    [main.c]
2021-01-05 added led signalling options and updated docs (#45)
    * control pwr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
    [main.c, sdk_config.h]
2021-01-08 Power Breakthrough! (#46)
    * Squashed commit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
    [Battery_Life_Calculator.xls]
